Veerasaravanans/dog-bot/project report/generated_images/fig_5_11_block_diagram.png

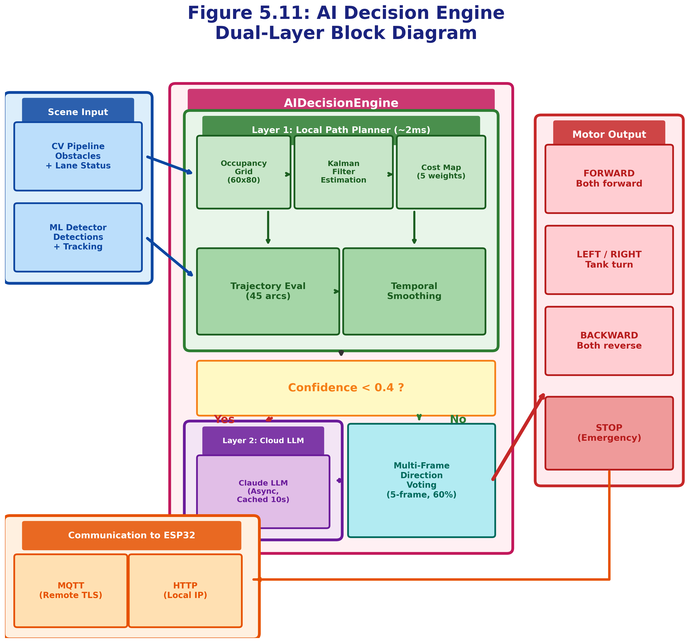
project report/generated_images/fig_5_11_block_diagram.png
