Veerasaravanans/dog-bot/project report/generated_images/fig_3_3_block_diagram.png

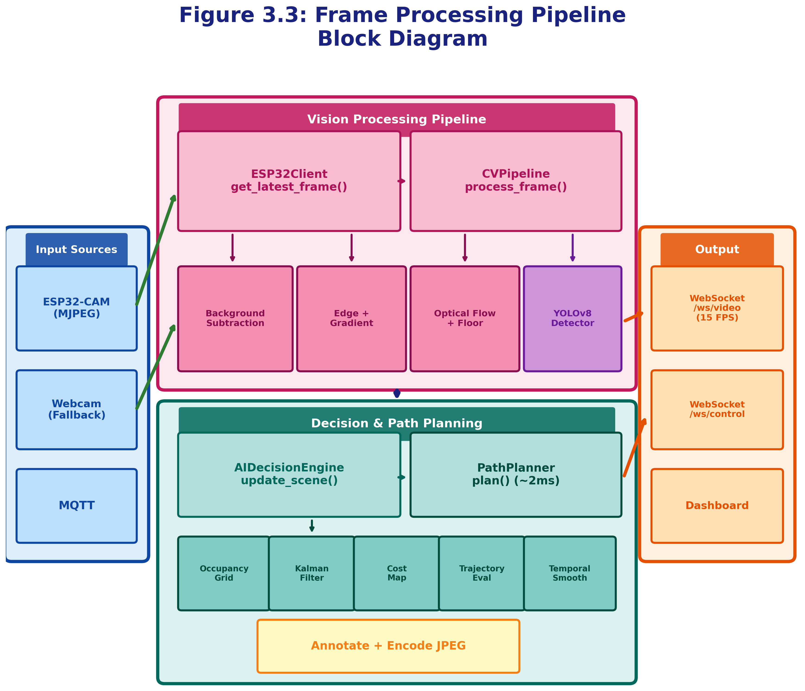
project report/generated_images/fig_3_3_block_diagram.png
