Veerasaravanans/dog-bot/pattent and paper presentation/6_ABSTRACT.docx

“Gesture-Controlled Autonomous Navigation System using Robot Operating System 2”

ABSTRACT

This paper primarily outlines a gesture-controlled autonomous navigation system for a four-wheeled robot based on ROS2 and different sensor technologies. The system employs a capacitive touch sensor, a magnetometer, and an ultrasonic sensor to facilitate easy robot control in the Gazebo simulation environment. The capacitive touch sensor identifies hand gestures, the magnetometer decides directional input, and the ultrasonic sensor helps in detecting obstacles. Hardware equipment consists of a microcontroller used to process sensory information and transfer it to ROS2 through Bluetooth. This set of equipment prevents jerky robotic movement changes as well as fine control over movement. Integration between ROS2 and Gazebo enables real-time simulation and testability, saves on development expenditures, and ensures improved robotic-human interaction. The system has possible uses in assistive robotics, automation, and robotic control without hands, and it represents a valuable development in autonomous navigation.
