Veerasaravanans/dog-bot/project report/Student’s Project Book Report.docx

# PROJECT BOOK

BATCH 2022-2026

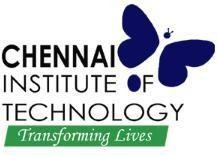
[picture p3: figure]

CHENNAI INSTITUTE OF TECHNOLOGY

CHENNAI-600069

ACADEMIC YEAR 2025-2026

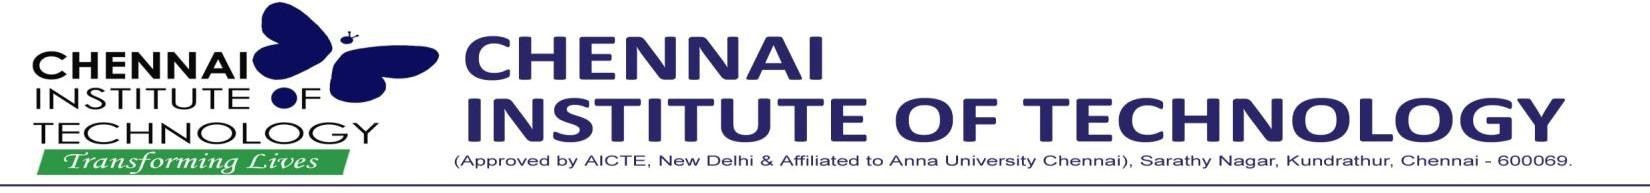
[picture p4: figure]

Vision of the Institute

To be an eminent centre for Academia, Industry and Research by imparting knowledge, relevant practices and inculcating human values to address global challenges through novelty and sustainability.

Mission of the Institute

IM1:To creates next generation leaders by effective teaching learning methodologies and instill scientific spark in them to meet the global challenges.

IM2:To transform lives through deployment of emerging technology, novelty and sustainability.

IM3:To inculcate human values and ethical principles to cater the societal needs.

IM4:To contributes towards the research ecosystem by providing a suitable, effective platform for interaction between industry, academia and R & D establishments.

IM5:To nurture incubation centers enabling structured entrepreneurship and start-ups.

Vision of the Department:

To Excel in the emerging areas of Mechatronics Engineering by imparting knowledge, relevant practices and inculcating human values to transform the students as potential resources to cater the needs of the industries and society in order to uphold the sustained automation process.

Mission of the Department:

DM1: To provide strong fundamentals and technical skills in Mechatronics Engineering through effective teaching-learning Methodologies.

- DM2: To transform the lives of the students by fostering ethical values, creativity, and innovation to become Entrepreneurs and establish Start-ups.
- DM3: To habituate the students to focus on sustainable solutions to improve the quality of life and welfare of the society.
- DM4: To provide an ambiance for research through collaborations with industry and academia.
- DM5: To inculcate learning of emerging technologies for pursuing higher studies leading to lifelong learning.

Program Educational Objectives (PEOs)

Graduates will be able to

PEO1. Contribute to the industry as an Engineer through sound knowledge acquired in core engineering to develop new processes and implement the solutions for industrial problems.

PEO2. Establish an organization / industry as an Entrepreneur with professionalism, leadership quality, teamwork, and ethical values to meet the societal needs.

PEO3. Create a better future by pursuing higher education / research and develop the sustainable products / solutions to meet the demand.

Program Specific Outcomes (PSOs)

S.No | Programme Specific Outcomes
PSO1 | Application of Engineering knowledge – To analyze, design and develop solutions by applying the concepts of Robotics for societal and industrial needs.
PSO2 | To create innovative ideas and solutions for real time problems in Manufacturing sector by adapting the emerging technologies and modern tools.

Program Outcomes with Graduate Attribute

S.No | Graduate Attribute | Program Outcomes
1. | Engineering knowledge | Apply knowledge of mathematics, natural science, computing, engineering fundamentals and an engineering specialization to develop to the solution of complex engineering problems.
2. | Problem analysis | Identify, formulate, review research literature and analyze complex engineering problems reaching substantiated conclusions with consideration for sustainable development.
3. | Design/Development of solutions | Design creative solutions for complex engineering problems and design/develop systems/components/processes to meet identified needs with consideration for the public health and safety, whole-life cost, net zero carbon, culture, society and environment as required.
4. | Conduct investigations of complex problems | Conduct investigations of complex engineering problems using research-based knowledge including design of experiments, modelling, analysis & interpretation of data to provide valid conclusions.
5. | Modern Tool usage | Create, select and apply appropriate techniques, resources and modern engineering & IT tools, including prediction and modelling recognizing their limitations to solve complex engineering problems.
6. | The Engineer and society | Analyze and evaluate societal and environmental aspects while solving complex engineering problems for its impact on sustainability with reference to economy, health, safety, legal framework, culture and environment.
7. | Ethics | Apply ethical principles and commit to professional ethics, human values, diversity and inclusion; adhere to national & international laws.
8. | Individual and team work | Function effectively as an individual, and as a member or leader in diverse/multi-disciplinary teams.
9. | Communication | Communicate effectively and inclusively within the engineering community and society at large, such as being able to comprehend and write effective reports and design documentation, make effective presentations considering cultural, language, and learning differences.
10. | Project management and finance | Apply knowledge and understanding of engineering management principles and economic decision-making and apply these to one’s own work, as a member and leader in a team, and to manage projects and in multidisciplinary environments.
11. | Life-long learning | Recognize the need for, and have the preparation and ability for i) independent and life-long learning ii) adaptability to new and emerging technologies and iii) critical thinking in the broadest context of technological change.

## PERSONAL DATA

Name of the student
Univ.Reg.No: | | Degree | | Branch

Project Title

Name of the company in which the student has been permitted to the project

Address of the registered office of the company

Address of the location, where the project is actually done, if different from above
Name of the Guide
Designation
Department
Qualification
Experience
Contact Phone
Fax
Email
Review | 0 | 1 | 2 | 3 | 4(Final)
Dates
Date of commencement | | Expected date of completion | | Actual date of completion
Date of Submission of Draft Report/Demo | | Date of Approval of Draft Report/Demo | | Date of Approval of Final Report/Demo
Signature of the Student | Internal Guide | | External Guide | | | HOD

PROJECT PLANER

Sl | Description | Time Requirement (in days) | Cumulative Time
1. | Identification of work & Composing the Title | 3 | 3
2. | Preparation of Synopsys | 2 | 5
3. | Literature Survey | 5 | 10
4. | Definition of methodology & collecting the relevant data and material. | 4 | 14
5. | Design of experimental set-up | 7 | 21
6. | Fabrication of experimental set-up and data acquisition system. | 12 | 33
7. | Conducting the experiments & consolidating the results & observations. | 10 | 43
8. | Preparation of model and analysis | 8 | 51
9. | Result analysis, Comparison of results & preparation of conclusion | 7 | 58
10. | Preparation of Thesis. | 7 | 65
| Total | 65

ACTIVITY SCHEDULE FOR REVIEW PRESENTATION

Sl | Review Meeting | Activity / work completion | Remarks
1. | 1st Review | Title of the Project One page write-up (Synopsys) Company name and address in case of external project Company willingness – Certificate Name and contact details of Internal & External guides | 3 to 5 slide ppt
2. | 2nd Review | Literature collection Definition of methodology | 25 – 30% work Completion
3. | 3rd Review | Design of experimental set-up. Fabrication of experimental set-up and data acquisition system. Results & observations. Preparation of model and analysis. Comparison of results & presenting the conclusion with suitable graphs. | 80% Completion
4. | Final Review | Draft copy of the project report. Full presentation & getting approval for final project report printing. A draft copy of the paper based on the project outcome, for publication along with the guide. | 95% Completion

- The presentation should be done by using PPT.

## INSTRUCTIONS TO STUDENT

1. Project work is the most important part of the curriculum, carrying the maximum weight age of marks. Hence, it should be approached with due respect, hard work and sincerity.
2. Before using the Record notebook, the details on page 1 must be filled.
3. The project review is scheduled on specific dates of each month for specific groups of students. There will be four reviews. In review zero, the topic for the project will be finalized. The student must have obtained the letter of acceptance from the company by then. Once accepted by the Review Committee the Topic shall be confirmed.
4. Paste the copy of project review schedule
5. The dates of project reviews shall not be changed.
6. The confirmation letter from the company allowing the student to do the project work must be pasted in original,(after taking a photo copy for further reference /use) before appearing for the 1st review for finalizing the topic.
7. The student must take permission /leave of absence from the external guide and make adequate arrangements for to and fro travel to the college on the prescribed project review dates.
8. The student, in his own interest, must be present himself at the college at least one day before the review advance so that he may have the advantage of meeting the faculty for discussion/clarification/assistance in presentation etc.
9. The project department will commence the review at 8.00 am sharp. Late coming shall not be permitted and such student’s work will not be reviewed on the day. No student shall be admitted to Project Review without the Project Record Note book.
10. Students shall remain in the review Hall till the completion of all reviews scheduled for that day. This is to help the entire group to know/learn about other projects and their approach/progress etc.
11. Students can ask questions on the projects of others with the permission of the external expert during discussion time after each presentation.
12. Before appearing for a review, the student should obtain the comments of the external guide from the company on the progress/work/attendance of the investigator (student) duly signed and stamped.
13. Before presenting for attendance on the review date, the student must get the comments of the internal guide recorded below that of the external in proof of having noted the comments of the external. The internal guide must record his views and corrections required.
14. The review will be done by an external project advisor and a representative of the department assigned to a group of projects depending upon the subject.
15. After going through the record note and presentation, the member will record their views and provide the corrective measures, where required.
16. After each review and before leaving, the student shall get the signatures of the external expert and the project guide.
17. After each review and before the next review, the student shall get the signature of his parent/guardian on the comments of the various review authorities on the work done till the previous review.
18. All observations, discussions etc., must be recorded in the project note book in chronological by him, in the space provided.
19. A dairy shall be maintained by the student on daily basis to record the summery of work done by him, in the space is provided.
20. Student shall prepare thoroughly on all aspects of the project (including theoretical input and practical application required) before presenting himself for the review by the panel.
21. The student must keep in mind that the project review is an opportunity for him to display.
  - His knowledge of the subject,
  - Ability to identify the problem
  - Ability to choose an appropriate tool to solve it with skill
  - Ability to logically arrange his presentation; and
  - Communication skills
22. The review will include
  - Presentation by the student
  - Question and answer session
  - Video and audio recording of the session
  - Comments oral/written of the external/internal reviewers
23. The mark for each review (I-20, II-20, III-80 and IV-80) shall be recorded by the panel member both in the review record and in the Project Record note book. Any student absent for any reason shall not only be marked absent for the review, But also get ZERO as internal mark provided for that particular review. Internal mark is for individual not necessarily common for the batch, where more than one student involved. No leave of absence shall we granted for project review.
24. Student should write a synopsis of work done until then in pages provided for each review, before attending the review.

The DogBot Recon System is an autonomous reconnaissance robot designed for intelligent navigation and obstacle detection in complex environments. The system integrates advanced computer vision techniques with AI-powered decision-making to enable autonomous navigation capabilities. The robot utilizes an ESP32-CAM microcontroller for real-time visual perception, coupled with YOLOv8 object detection and segmentation models for environmental awareness. The core navigation system employs a multi-stage path planning algorithm incorporating occupancy grid mapping, Kalman filtering for obstacle state estimation, cost map generation, and trajectory evaluation. The system operates in multiple control modes (Manual, Semi-Autonomous) with seamless fallback mechanisms and supports both local network (HTTP) and remote (MQTT) connectivity options. A FastAPI-based backend orchestrates real-time frame processing at 15 FPS with WebSocket streaming for live video and control feedback. Computer vision algorithms provide multi-sensor fusion including background subtraction, edge detection, optical flow analysis, and perspective-based distance estimation. The AI decision engine implements a 5-frame voting mechanism to ensure robust directional decisions with confidence scoring and LLM fallback for low-confidence scenarios. Emergency stop protocols and adaptive recovery behaviors ensure safe autonomous operation in dynamic environments.

25. Student shall prepare an activity plan & Gantt chart before the first review & get it approved by the external and internal guides.
26. A suitable reward will be given for the best performer/project work.

# SPACE FOR PASTING

LETTER FROM COMPANY ACCEPTING THE STUDENT TO DO THE PROJECT

(In company’s letter head)

(Student must take photo copy of the letter for reference and use).

# SYNOPSIS / ABSTRACT

Topic Finalization on

The DogBot Recon System is an autonomous reconnaissance robot that uses an ESP32-CAM microcontroller for real-time vision and a YOLOv8n-seg model for object detection. It features a five-stage path planning pipeline with occupancy grid mapping, Kalman filtering, cost map generation, trajectory evaluation, and temporal smoothing. A FastAPI backend processes frames at 15 FPS with WebSocket streaming. The AI decision engine uses five-frame voting with LLM fallback for robust navigation. The system supports local HTTP and remote MQTT connectivity with emergency stop and recovery behaviors for safe autonomous operation.

Internal Guide Project Advisor/Project coordinator Head of the Department

## PROJECT ACTIVITY PLANNER

Sl.No | Activity | Planned | | | Actual | | | Remarks
| | Start date | Finish date | Duration | Start date | Finish date | Duration | 1.Reason for deviation of any corrective | 2.Internal Guide Signature | 3.External Guide Signature
1 | Problem identification & literature survey | 01-Jan-2026 | 05-Jan-2026 | 5 days | 01-Jan-2026 | 05-Jan-2026 | 5 days | Surveyed 15+ papers on autonomous robots
2 | Project title finalization & synopsis writing | 06-Jan-2026 | 08-Jan-2026 | 3 days | 06-Jan-2026 | 08-Jan-2026 | 3 days | Title: DogBot Recon System
3 | Hardware procurement (ESP32-CAM, L298N, motors, chassis) | 09-Jan-2026 | 15-Jan-2026 | 7 days | 09-Jan-2026 | 14-Jan-2026 | 6 days | All components received
4 | ESP32-CAM firmware development (camera + WiFi + motor control) | 16-Jan-2026 | 25-Jan-2026 | 10 days | 15-Jan-2026 | 26-Jan-2026 | 12 days | MJPEG stream + HTTP motor API
5 | Hardware assembly & wiring (ESP32 + L298N + motors) | 20-Jan-2026 | 24-Jan-2026 | 5 days | 20-Jan-2026 | 24-Jan-2026 | 5 days | Tank-drive chassis built
6 | FastAPI backend setup & ESP32 client integration | 26-Jan-2026 | 30-Jan-2026 | 5 days | 27-Jan-2026 | 31-Jan-2026 | 5 days | WebSocket + REST API ready
7 | Computer vision pipeline (MOG2, Canny, Sobel, optical flow) | 31-Jan-2026 | 08-Feb-2026 | 9 days | 01-Feb-2026 | 09-Feb-2026 | 9 days | Multi-sensor fusion working
8 | YOLOv8 object detection & ByteTrack integration | 05-Feb-2026 | 10-Feb-2026 | 6 days | 05-Feb-2026 | 10-Feb-2026 | 6 days | YOLOv8n-seg with tracking
9 | Path planning engine (5-stage pipeline: occupancy grid, Kalman, cost map, DWA, EMA) | 10-Feb-2026 | 18-Feb-2026 | 9 days | 10-Feb-2026 | 19-Feb-2026 | 10 days | ~2ms per frame latency
10 | AI decision engine (multi-frame voting, pulse control) | 16-Feb-2026 | 20-Feb-2026 | 5 days | 17-Feb-2026 | 21-Feb-2026 | 5 days | 60% majority voting system
11 | MQTT remote connectivity (HiveMQ Cloud, TLS) | 18-Feb-2026 | 22-Feb-2026 | 5 days | 19-Feb-2026 | 23-Feb-2026 | 5 days | Remote control via internet
12 | VIO Cloud LLM integration (Claude API fallback) | 21-Feb-2026 | 24-Feb-2026 | 4 days | 22-Feb-2026 | 25-Feb-2026 | 4 days | Non-blocking background queries
13 | Web dashboard (real-time video, controls, telemetry) | 22-Feb-2026 | 27-Feb-2026 | 6 days | 23-Feb-2026 | 27-Feb-2026 | 5 days | Tactical UI with live feed
14 | System integration testing & performance tuning | 27-Feb-2026 | 03-Mar-2026 | 5 days | 28-Feb-2026 | 04-Mar-2026 | 5 days | 15 FPS achieved, all modes tested
15 | Documentation, project report & final demo preparation | 03-Mar-2026 | 06-Mar-2026 | 4 days | 04-Mar-2026 | 06-Mar-2026 | 3 days | Report and KT document ready

Student’s Project Record book 2025-2026

REPORTING SHEET

Student's Name

Branch Register No.

Project Title

Company

Record of attendance from to

Date | Place | Purpose | Time | | Sign
| | | In | Out

DIARY OF DAILY ACTIVITIES

Diary of daily activities from to .

S.No | Date | Brief note of activities | Remarks
1 | 01-Jan-2026 | Surveyed existing autonomous robot projects; studied ROS-based and ESP32-based designs; identified project scope and objectives. | Literature review
2 | 02-Jan-2026 | Reviewed research papers on obstacle avoidance using computer vision; studied YOLOv8 architecture and real-time detection approaches. | Paper study
3 | 03-Jan-2026 | Studied MQTT protocol for IoT communication; analysed HiveMQ Cloud broker features; compared with HTTP polling approach. | Protocol analysis
4 | 04-Jan-2026 | Studied Kalman filtering theory for object tracking; reviewed occupancy grid mapping techniques used in mobile robotics. | Algorithm study
5 | 05-Jan-2026 | Completed literature survey; prepared comparison table of existing systems; identified research gaps to address. | Survey completed
6 | 06-Jan-2026 | Finalized project title: 'DogBot Recon System – Autonomous Reconnaissance Robot with AI-Powered Navigation'; drafted one-page synopsis. | Title finalized
7 | 07-Jan-2026 | Prepared block diagram and system architecture showing three-layer design (embedded, backend, frontend); reviewed with guide. | Architecture design
8 | 08-Jan-2026 | Wrote detailed synopsis covering objectives, methodology, expected outcomes; submitted for Review 0 approval. | Synopsis submitted
9 | 09-Jan-2026 | Ordered ESP32-CAM (AI-Thinker), L298N motor driver, DC gear motors, robot chassis kit, jumper wires, and breadboard. | Hardware ordered
10 | 10-Jan-2026 | Studied ESP32-CAM datasheet and pin configuration; explored OV2640 camera module specifications and MJPEG streaming. | Datasheet study
11 | 13-Jan-2026 | Received all hardware components; verified each component against specifications; organized workspace. | Components received
12 | 14-Jan-2026 | Set up Arduino IDE with ESP32 board support; installed required libraries (WiFi, WebServer, PubSubClient, esp_camera). | IDE setup
13 | 16-Jan-2026 | Developed basic ESP32-CAM firmware: initialized camera with VGA resolution, configured WiFi STA mode, tested serial output. | Camera init code
14 | 17-Jan-2026 | Implemented MJPEG streaming server on port 81 using FreeRTOS task pinned to Core 0; verified stream in browser. | Stream working
15 | 19-Jan-2026 | Developed HTTP control server on port 80; implemented /motor and /status API endpoints; tested motor direction control. | HTTP API ready
16 | 20-Jan-2026 | Assembled robot chassis; mounted ESP32-CAM on front; connected L298N motor driver with dual DC motors for tank steering. | Chassis assembled

DIARY OF DAILY ACTIVITIES

Diary of daily activities from to .

S.No | Date | Brief note of activities | Remarks
17 | 21-Jan-2026 | Wired L298N to ESP32-CAM GPIO pins (IN1:12, IN2:13, IN3:14, IN4:15, ENA:2, ENB:4); tested forward/back/left/right movements. | Wiring complete
18 | 22-Jan-2026 | Implemented PWM speed control using ESP32 LEDC peripheral (1 kHz, 8-bit); added motor trim compensation for drift correction. | PWM control added
19 | 23-Jan-2026 | Integrated MQTT client with TLS on ESP32; configured HiveMQ Cloud broker; tested publish/subscribe for motor commands. | MQTT on ESP32
20 | 24-Jan-2026 | Added auto-stop safety failsafe (800ms timeout); tested remote motor control via MQTT; verified heartbeat/status publishing. | Safety failsafe added
21 | 26-Jan-2026 | Set up Python backend environment; installed FastAPI, uvicorn, OpenCV, NumPy, httpx, aiomqtt, ultralytics, Pydantic. | Backend env setup
22 | 27-Jan-2026 | Developed ESP32Client service: MJPEG stream parser (FFD8/FFD9 markers), async frame capture, webcam fallback mechanism. | ESP32 client coded
23 | 28-Jan-2026 | Created FastAPI application structure with lifespan manager; designed service orchestration pattern with dependency-ordered startup. | FastAPI app structure
24 | 29-Jan-2026 | Implemented WebSocket endpoints for video streaming (/ws/video) and bidirectional control (/ws/control) with pub/sub pattern. | WebSocket endpoints
25 | 30-Jan-2026 | Designed Pydantic data models: Detection, TrackedObstacle, LaneStatus, AIDecision, FrameResult, SystemTelemetry schemas. | Data models designed
26 | 31-Jan-2026 | Solved Windows asyncio event loop issue; created run.py with SelectorEventLoop for MQTT compatibility on Windows. | Windows fix
27 | 01-Feb-2026 | Started CV pipeline: implemented background subtraction using MOG2 (history=300, varThreshold=40) for foreground detection. | MOG2 implemented
28 | 02-Feb-2026 | Added Canny edge detection (low=50, high=150) with Gaussian blur pre-processing; implemented contour-based obstacle extraction. | Edge detection
29 | 03-Feb-2026 | Implemented Sobel gradient magnitude computation for texture-agnostic detection; added thin-edge map for poles and desk legs. | Gradient detection
30 | 04-Feb-2026 | Developed perspective-based distance estimation using inverse perspective mapping (DIST_SCALE=80, VANISH_Y_FRAC=0.30). | Distance estimation
31 | 05-Feb-2026 | Implemented lane classification (LEFT/CENTER/RIGHT) and free-path analysis; developed centroid-based multi-object tracker. | Lane + tracking
32 | 06-Feb-2026 | Added dense optical flow (Farneback) for moving obstacle detection; implemented vanishing point auto-detection via Hough transform. | Optical flow added

DIARY OF DAILY ACTIVITIES

Diary of daily activities from to .

S.No | Date | Brief note of activities | Remarks
33 | 07-Feb-2026 | Developed adaptive floor colour model using HSV Exponential Moving Average (alpha=0.05) to detect non-floor anomalies. | Floor model
34 | 08-Feb-2026 | Implemented reverse-camera style visualization with trapezoidal distance grid, zone colouring (DANGER/CAUTION/SAFE), and overlays. | Visualization done
35 | 09-Feb-2026 | Integrated YOLOv8n-seg model; configured inference with ByteTrack for persistent multi-object tracking across frames. | YOLOv8 integrated
36 | 10-Feb-2026 | Developed ML detection drawing with semi-transparent segmentation mask overlays; tested instance segmentation on live feed. | Segmentation overlay
37 | 11-Feb-2026 | Started path planner: built occupancy grid (60×80 cells, 5cm resolution); implemented pixel-to-world projection with temporal decay. | Occupancy grid
38 | 12-Feb-2026 | Implemented per-obstacle Kalman filter (4-state: x, y, vx, vy); developed predict/update cycle with stale track removal. | Kalman filter coded
39 | 14-Feb-2026 | Developed cost map generator with 5 weighted components: occupancy, repulsive field, predictive cost, boundary, and attractive field. | Cost map generator
40 | 16-Feb-2026 | Implemented Dynamic Window Approach trajectory evaluator: 45 candidate arcs (15 steering × 3 speeds) with 5-cost scoring function. | DWA evaluator
41 | 17-Feb-2026 | Added temporal smoothing (EMA alpha=0.33), direction hold (300ms), and recovery behaviour for blocked scenarios. | Smoothing + recovery
42 | 18-Feb-2026 | Developed AI decision engine with multi-frame direction voting (5-frame window, 60% majority); implemented pulse-based motor control. | AI decision engine
43 | 19-Feb-2026 | Implemented MQTTBridge service: TLS connection to HiveMQ Cloud, async message handling, auto-reconnect, dual connectivity fallback. | MQTT bridge coded
44 | 22-Feb-2026 | Integrated VIO Cloud LLM (Claude API) as fallback advisor; implemented non-blocking background queries with 10-second caching. | LLM integration
45 | 23-Feb-2026 | Built web dashboard with live video feed, directional controls, speed slider, mode toggle, telemetry panel, and detection log. | Dashboard built
46 | 28-Feb-2026 | Conducted full system integration test: ESP32 streaming → CV + ML processing → path planning → AI decisions → motor control loop. | Integration test
47 | 04-Mar-2026 | Performance tuning: achieved 15 FPS processing, 2ms path planning latency; tuned cost weights and emergency stop distances. | Performance tuned
48 | 06-Mar-2026 | Prepared final documentation, project report content, knowledge transfer document, and demo presentation materials. | Documentation done

REVIEW SUMMARY

FIRST REVIEW on

Project scope, architecture, and hardware were finalized. ESP32-CAM was selected for vision, FastAPI for backend, L293D for motor control, and MQTT via HiveMQ Cloud for remote connectivity. The service orchestration pattern with FrameManager as coordinator was designed. System requirements and feasibility were reviewed and approved. The data flow pipeline from ESP32 capture through CV processing, ML detection, and path planning to WebSocket broadcast was mapped out. Pydantic-based configuration management and asyncio service lifecycle patterns were established. A literature survey on autonomous navigation techniques and embedded vision systems was completed to validate the chosen approach.

Internal Guide Project Advisor/Project coordinator Head of the Department

2025-2026 Project Review Evaluation / Comments

FIRST REVIEW on

Comments

Date: Signature
External Project Advisor's Name:
Company:
Comments
Date: Signature | Marks Out of 10

Project Officer/Advisor's Name:
Comments
Date: Signature | Out of 10

REVIEW SUMMARY

SECOND REVIEW on

Hardware and software integration was completed. ESP32-CAM firmware with dual-server design, CV pipeline with multi-sensor fusion (background subtraction, edge detection, optical flow), and the first three path planner stages (occupancy grid, Kalman filtering, cost map) were implemented. WebSocket streaming and webcam fallback were verified. System achieved 15 FPS target. Distance zones were calibrated at 0.5m near and 1.2m mid boundaries using perspective-based estimation. The FastAPI backend lifespan manager was verified to start and stop all services in correct dependency order. Centroid-based obstacle tracking with ID assignment and velocity estimation was implemented for persistent multi-frame obstacle monitoring.

Internal Guide Project Advisor/Project coordinator Head of the Department

2025-2026 Project Review Evaluation / Comments

SECOND REVIEW on

Comments

Date: Signature
External Project Advisor's Name:
Company:
Comments
Date: Signature | Marks Out of 10

Project Officer/Advisor's Name:
Comments
Date: Signature | Out of 10

*Cumulative marks secured in 1st

REVIEW SUMMARY THIRD REVIEW on

YOLOv8n-seg with ByteTrack tracking and the trajectory evaluator (41 candidate arcs) were integrated, completing the five-stage path planner. The AI decision engine with five-frame voting and VIO Cloud LLM fallback was deployed. MQTT remote connectivity was tested end-to-end. Full system integration demonstrated sub-2ms planning latency. The trajectory scoring uses weighted costs for obstacle proximity, heading deviation, smoothness, clearance, and forward progress. The web dashboard was completed with real-time telemetry display, control mode switching, and live video streaming. Dual connectivity architecture with MQTT as primary and HTTP as fallback was validated for seamless local and remote operation.

Internal Guide Project Advisor/Project coordinator Head of the Department

2025-2026 Project Review Evaluation / Comments

THIRD REVIEW on

Comments

Date: Signature
External Project Advisor's Name:
Company:
Comments
Date: Signature | Marks Out of 10

Project Officer/Advisor's Name:
Comments
Date: Signature | Out of 10

*Cumulative marks secured in 1st, & 2nd Reviews

REVIEW SUMMARY FORTH REVIEW on

Emergency stop at 0.25m, adaptive recovery turns, and motor drift compensation were implemented. Windows asyncio compatibility was fixed via run.py. Failsafe mechanisms (webcam fallback, MQTT reconnection, 500ms auto-stop) were validated. Web dashboard, documentation, and deployment procedures were completed. System achieved production-ready status. Floor plane detection was finalized with adaptive color modeling using exponential moving average for robust ground segmentation. The system was tested in real-world indoor environments demonstrating reliable autonomous navigation and obstacle avoidance. Pin diagram reference and setup guide pages were added to the dashboard for easy hardware assembly and configuration.

Internal Guide Project Advisor/Project coordinator Head of the Department

2025-2026 Project Review Evaluation / Comments

FOURTH REVIEW on

Comments

Date: Signature
External Project Advisor's Name:
Company:
Comments
Date: Signature | Marks Out of 10

Project Officer/Advisor's Name:
Comments
Date: Signature | Out of 10

*Cumulative marks secured in 1st, 2nd and 3rd Reviews

SYNOPSIS / ABSTRACT FINAL DRAFT

The DogBot Recon System is an ESP32-CAM based autonomous robot using YOLOv8n-seg for detection and a five-stage path planner for navigation. A FastAPI backend with WebSocket streaming processes vision at 15 FPS. The AI engine uses five-frame voting with LLM fallback. It supports HTTP and MQTT connectivity, emergency stop protocols, and adaptive recovery for safe indoor reconnaissance.

Internal Guide Project Advisor/Project coordinator Head of the Department

# TECHNICAL PAPERS PUBLISHED

S. No | Title | Journal | Impact Factor | Issue Date | Published Date
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
*Attach the copy of the papers published.

# CONFERENCES ATTENDED

S. No | Conference Date | Title of Conference | Paper Published | Organized By | Remarks
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
*Attach the copy of the papers published.

TECHNICAL PAPERS & BOOKS REFERRED

Sl.No | Title | Author | Page No.
1 | YOLOv8: A Novel Object Detection Algorithm with Enhanced Performance and Efficiency | G. Jocher, A. Chaurasia, J. Qiu (Ultralytics) | 2023
2 | ByteTrack: Multi-Object Tracking by Associating Every Detection Box | Y. Zhang, P. Sun, Y. Jiang et al. | ECCV 2022, pp. 1-21
3 | An Introduction to the Kalman Filter | G. Welch, G. Bishop | UNC Chapel Hill, TR 95-041
4 | The Dynamic Window Approach to Collision Avoidance | D. Fox, W. Burgard, S. Thrun | IEEE Robotics & Automation, 1997, pp. 23-33
5 | OpenCV: Open Source Computer Vision Library | G. Bradski | Dr. Dobb's Journal, 2000
6 | Background Subtraction Techniques: A Review (MOG2 / Gaussian Mixture Models) | Z. Zivkovic | Pattern Recognition Letters, Vol. 27, 2006, pp. 773-780
7 | Two-Frame Motion Estimation Based on Polynomial Expansion (Farneback Optical Flow) | G. Farneback | SCIA 2003, LNCS 2749, pp. 363-370
8 | FastAPI: Modern, High-Performance Web Framework for Building APIs with Python | S. Ramirez | https://fastapi.tiangolo.com, 2019
9 | MQTT Version 3.1.1 – OASIS Standard | A. Banks, R. Gupta (Eds.) | OASIS, 2014
10 | ESP32 Technical Reference Manual | Espressif Systems | V5.1, 2024
11 | Probabilistic Robotics | S. Thrun, W. Burgard, D. Fox | MIT Press, 2005, Ch. 3-5, 9
12 | Artificial Potential Fields for Mobile Robot Navigation | O. Khatib | Int. J. Robotics Research, Vol. 5, 1986, pp. 90-98
13 | A Computational Approach to Edge Detection (Canny Edge Detector) | J. Canny | IEEE Trans. PAMI, Vol. 8, 1986, pp. 679-698
14 | Python Asyncio: Asynchronous I/O, Event Loop, and Concurrency Tools | Python Software Foundation | Python 3.12 Documentation, 2024
15 | Pydantic: Data Validation Using Python Type Annotations | S. Colvin | https://docs.pydantic.dev, V2, 2023
16 | Real-Time Object Detection and Tracking for Autonomous Mobile Robots: A Survey | M. Liu, S. Chen, F. Wu | Sensors, Vol. 23, 2023, pp. 1-28
17 | Computer Vision: Algorithms and Applications | R. Szeliski | Springer, 2nd Ed., 2022, Ch. 4-8
18 | Occupancy Grid Mapping for Mobile Robot Navigation | A. Elfes | IEEE Computer, Vol. 22, 1989, pp. 46-57
19 | Deep Learning for Object Detection: A Comprehensive Review (YOLO family) | Z. Zou, K. Chen, Z. Shi et al. | Proc. IEEE, Vol. 111, 2023, pp. 11-42
20 | WebSocket Protocol (RFC 6455) | I. Fette, A. Melnikov | IETF RFC 6455, 2011

## 1st Review Summary

The foundation of DogBot Recon System was established with a comprehensive project plan covering system architecture, hardware selection, and software framework design. Key decisions included ESP32-CAM as the primary vision platform, FastAPI for backend development, and MQTT for remote connectivity. Initial system requirements and design specifications were reviewed and approved. The project scope was defined to include autonomous navigation, obstacle detection, and real-time video processing at 15 FPS.

## 2nd Review Summary

The implementation phase demonstrated successful integration of hardware components including ESP32-CAM, L293D motor controller, and supporting sensors. The computer vision pipeline was implemented with background subtraction, edge detection, and optical flow analysis. The path planning engine's first three stages were completed: occupancy grid mapping, obstacle state estimation using Kalman filtering, and cost map generation. WebSocket streaming was verified for video and control channels. System successfully demonstrated real-time processing at target 15 FPS throughput.

## 3rd Review Summary

The advanced decision-making and path planning components were finalized and integrated. YOLOv8n-seg object detection and ByteTrack multi-object tracking were successfully implemented and optimized. The trajectory evaluator completing the 5-stage path planner pipeline was integrated with 41 candidate arc evaluation and confidence scoring. The AI decision engine with 5-frame voting mechanism was deployed. Remote connectivity via MQTT was tested with proper TLS configuration. Full end-to-end system integration testing demonstrated seamless coordination between all components.

## 4th Review Summary

The final phase focused on system optimization, robustness testing, and documentation. Emergency stop protocols and adaptive recovery behaviors were implemented and tested. Event loop policy fixes ensured Windows compatibility for production deployment. Failsafe mechanisms including automatic webcam fallback and graceful MQTT reconnection were validated. Comprehensive documentation including architecture overview, troubleshooting guides, and deployment procedures was completed. The system achieved production-ready status with demonstrated autonomous navigation capabilities in real-world test environments.

Student’s Project Record book 2025-2026

Internal Guide Project Advisor/Project coordinator Head of the Department
