Veerasaravanans/dog-bot/pattent and paper presentation/7_DRAWING.docx

“Gesture-Controlled Autonomous Navigation System using Robot Operating System 2”

DRAWINGS

Figure-I Block Diagram of the proposed system

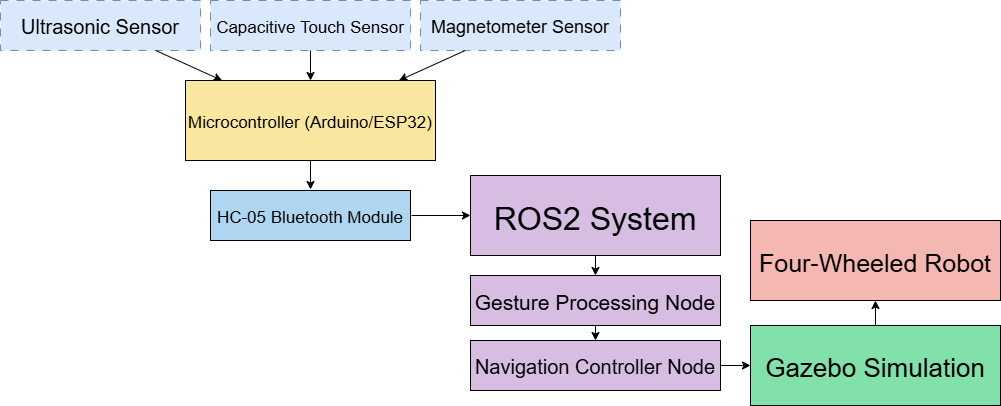
[picture p25: figure]

FIGURE 2: Working model of the proposed system

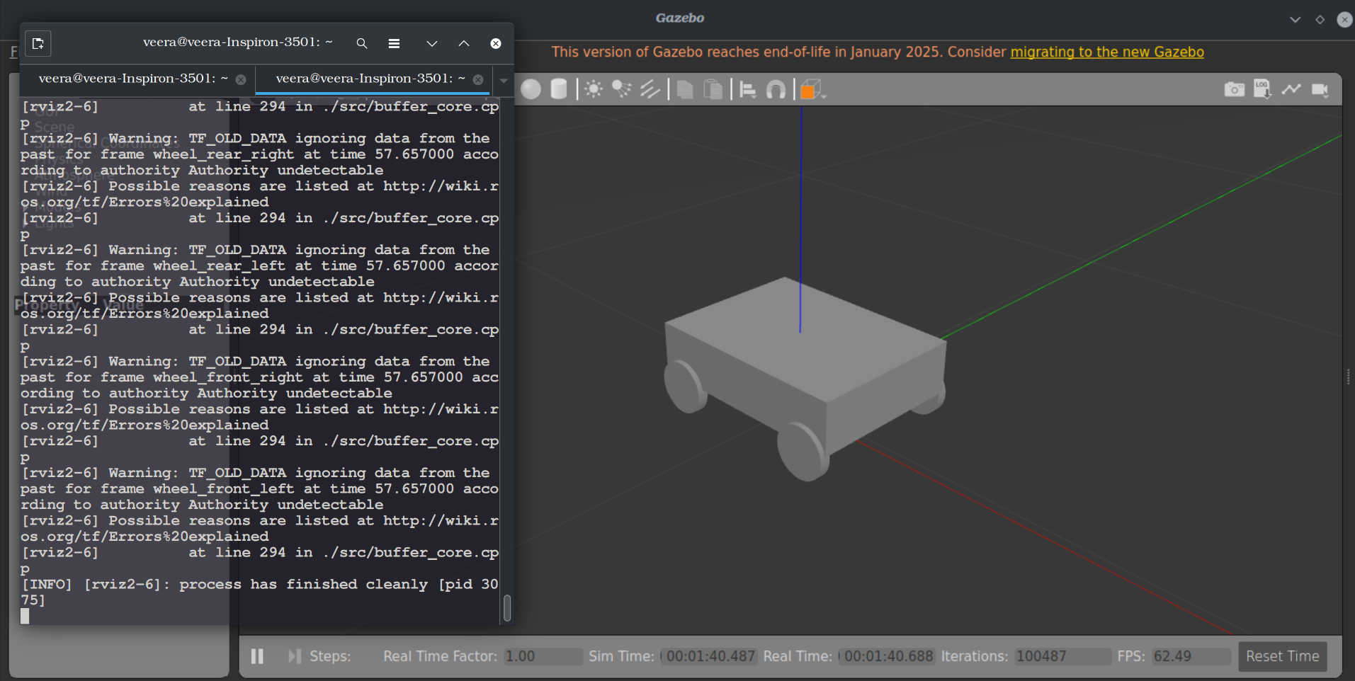
[picture p26: figure]
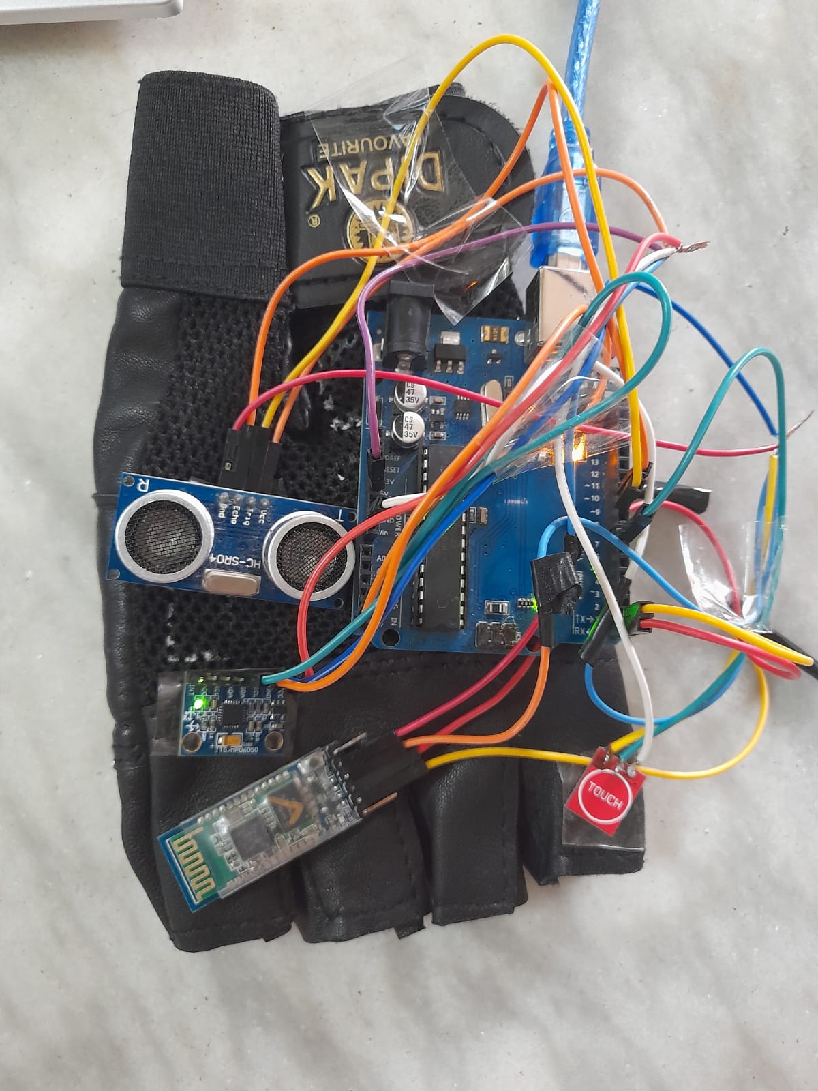
[picture p27: figure]
