Veerasaravanans/dog-bot/project report/block dia and graphs.docx

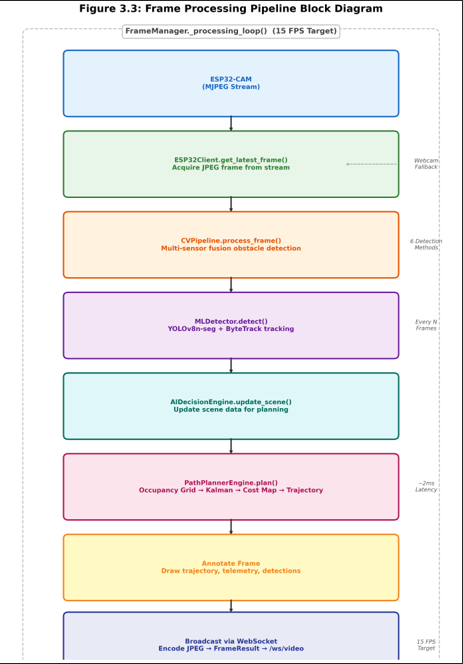
[picture p28: figure]

Fig 3.2.1

Fig 5.7.1

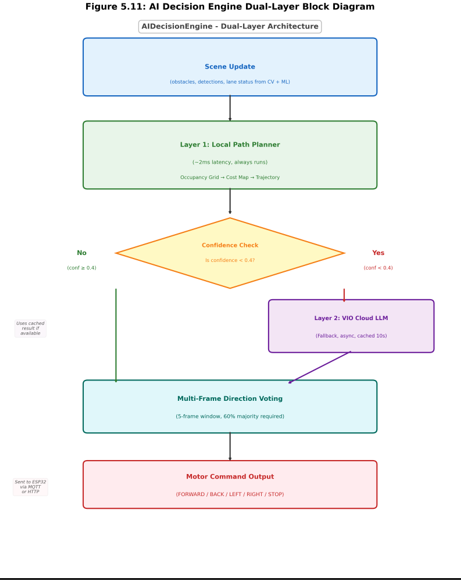
[picture p29: figure]

Table 4.7.2

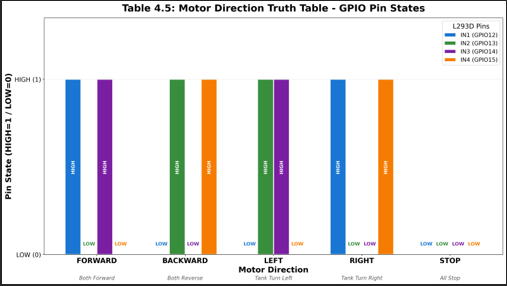
[picture p30: figure]

Table 6.2.1

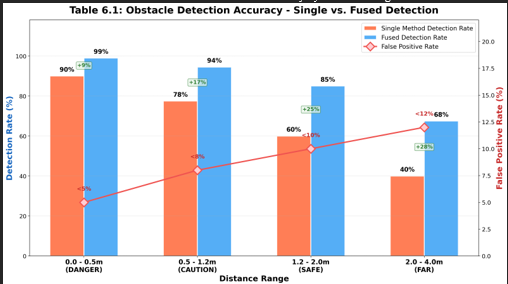
[picture p31: figure]
