Veerasaravanans/dog-bot/fix and md/REMOTE_ACCESS_GUIDE.md

# Remote ESP32-CAM Access Guide

## Current Situation

**Problem:** Your ESP32-CAM is on a local network (192.168.1.100) in Chennai, but you want to access it remotely from anywhere.

**Current Architecture:**
- ✅ **MQTT Control:** Already working! Motor commands work remotely via HiveMQ Cloud
- ❌ **Video Stream:** Only works on local network (HTTP MJPEG on port 81)
- ✅ **Motor Status:** Published to MQTT (accessible remotely)

---

## Solution Options (Ranked by Ease)

### **Option 1: VPN - RECOMMENDED** ⭐
**Best for:** Secure remote access without firmware changes

#### How It Works
1. Set up VPN server on the same network as your ESP32-CAM (in Chennai)
2. Connect to VPN from anywhere
3. Access ESP32-CAM as if you're on the local network

#### Steps:
```bash
# On router/server in Chennai:
# Install OpenVPN, WireGuard, or use Tailscale (easiest)

# Example with Tailscale (free, super easy):
1. Install Tailscale on a computer in Chennai network
2. Install Tailscale on your remote computer
3. Both join same Tailscale network
4. Access ESP32 at its local IP (192.168.1.100)
```

#### Pros:
- ✅ Secure (encrypted)
- ✅ No firmware changes needed
- ✅ Works for all devices on the network
- ✅ Video stream works at full quality

#### Cons:
- ⚠️ Requires VPN server/client setup
- ⚠️ Needs a computer/Pi running 24/7 in Chennai

---

### **Option 2: Port Forwarding** ⚠️
**Best for:** Quick testing (NOT recommended for production)

#### How It Works
1. Forward external port (e.g., 8081) to ESP32-CAM's port 81
2. Access via your public IP: `http://YOUR_PUBLIC_IP:8081/stream`

#### Steps:
```bash
# On router in Chennai:
1. Find ESP32 local IP: 192.168.1.100
2. Log into router admin panel
3. Port Forwarding settings:
   - External Port: 8081
   - Internal IP: 192.168.1.100
   - Internal Port: 81
   - Protocol: TCP
4. Find your public IP: curl ifconfig.me
5. Access: http://YOUR_PUBLIC_IP:8081/stream
```

#### Pros:
- ✅ Simple setup
- ✅ No firmware changes
- ✅ Direct access

#### Cons:
- ❌ **MAJOR SECURITY RISK** (anyone can access if they know your IP)
- ❌ No encryption
- ❌ Public IP might change (need DDNS)
- ❌ ISP might block incoming connections

---

### **Option 3: Cloud Relay Service** 🌐
**Best for:** Simplest for non-technical users

#### Recommended Services:
1. **ngrok** (free tier available)
   ```bash
   # Install ngrok on computer in Chennai
   ngrok http 192.168.1.100:81
   # Get public URL: https://abc123.ngrok.io
   ```

2. **Cloudflare Tunnel** (free)
   ```bash
   # Install cloudflared in Chennai
   cloudflared tunnel --url http://192.168.1.100:81
   ```

3. **Tailscale + Funnel** (free, easiest)
   ```bash
   # Expose local service publicly
   tailscale funnel 81
   ```

#### Pros:
- ✅ No router configuration needed
- ✅ HTTPS encryption included
- ✅ Easy to set up
- ✅ Firewall-friendly

#### Cons:
- ⚠️ Free tiers have bandwidth/time limits
- ⚠️ Third-party service dependency
- ⚠️ May have latency

---

### **Option 4: Update .env to Use MQTT Backend (Current Workaround)**
**Best for:** Testing with webcam fallback

Your system already handles this gracefully:
```bash
# Edit .env file:
ESP32_STREAM_URL=http://192.168.1.100:81/stream  # Can't reach from remote

# System automatically:
# 1. Tries ESP32 stream
# 2. Falls back to local webcam ✅
# 3. MQTT control still works ✅
```

#### Current Status:
- ✅ Motor control works remotely via MQTT
- ✅ Status updates work remotely via MQTT
- ✅ Local webcam provides video feed
- ❌ Can't see Chennai ESP32-CAM video

---

### **Option 5: Implement MQTT Video Streaming** 🔧
**Best for:** Advanced users, full remote capability

#### What Needs to Change:

**ESP32 Firmware Changes:**
```cpp
// Add MQTT video publishing to esp32cam_dogbot.ino
void mqttPublishFrame() {
  camera_fb_t * fb = esp_camera_fb_get();
  if (!fb) return;

  // Compress JPEG (already done by camera)
  // Split into chunks (MQTT message size limit ~256KB)
  size_t chunkSize = 4096;
  for (size_t i = 0; i < fb->len; i += chunkSize) {
    size_t len = min(chunkSize, fb->len - i);
    mqttClient.publish(TOPIC_FRAME, &fb->buf[i], len);
  }

  esp_camera_fb_return(fb);
}
```

**Backend Changes:**
```python
# backend/services/esp32_client.py
# Add MQTT frame subscriber
async def _on_mqtt_frame(self, message):
    # Reconstruct frame from MQTT chunks
    # Update self._frame
    pass
```

#### Pros:
- ✅ Fully remote without VPN/port forwarding
- ✅ Uses existing MQTT infrastructure
- ✅ Secure (TLS encryption)

#### Cons:
- ❌ Complex implementation
- ❌ MQTT bandwidth limitations
- ❌ Lower frame rate (3-5 FPS max realistic)
- ❌ Higher latency than HTTP streaming

---

## Recommended Solution for Your Setup

### **Immediate (Works Now):**
Use **Tailscale VPN** - Free, secure, easiest setup:

#### Quick Start:
```bash
# On a computer in Chennai (same network as ESP32):
1. Download Tailscale: https://tailscale.com/download
2. Install and sign in
3. Leave running 24/7

# On your remote computer:
1. Download Tailscale
2. Install and sign in (same account)
3. You're now on the same virtual network!

# Access ESP32:
http://192.168.1.100:81/stream  # Works as if you're local!
```

### **Alternative (Temporary Testing):**
Use **ngrok** for quick testing:

```bash
# On computer in Chennai:
1. Download ngrok: https://ngrok.com/download
2. Run: ngrok http 192.168.1.100:81
3. Copy the https://xyz.ngrok.io URL
4. Update .env:
   ESP32_STREAM_URL=https://xyz.ngrok.io/stream
5. Restart: python run.py
```

---

## Configuration Changes Needed

### **Update .env for Remote Access:**

```bash
# Current (local only):
ESP32_STREAM_URL=http://192.168.1.100:81/stream
ESP32_CONTROL_URL=http://192.168.1.100

# After VPN setup (Tailscale):
ESP32_STREAM_URL=http://192.168.1.100:81/stream  # Works through VPN
ESP32_CONTROL_URL=http://192.168.1.100

# After ngrok setup:
ESP32_STREAM_URL=https://abc123.ngrok.io/stream  # Public URL
ESP32_CONTROL_URL=https://abc123.ngrok.io

# For testing without ESP32:
# Leave as-is, system uses webcam fallback automatically
```

---

## Troubleshooting Remote Access

### **ESP32 Not Reachable:**
```bash
# Check if ESP32 is powered on
# Check WiFi connection (ESP32 Serial Monitor)
# Verify local network connectivity first

# From Chennai computer:
ping 192.168.1.100
curl http://192.168.1.100/status
```

### **MQTT Control Working but No Video:**
✅ **This is expected!** Your current setup:
- MQTT = Remote control ✅
- HTTP Stream = Local network only ❌

**Solution:** Set up VPN or ngrok (see above)

### **Firewall Issues:**
```bash
# ESP32 firmware includes CORS headers
# Should work from any origin

# If blocked, check:
- Windows Firewall
- Router firewall
- ISP restrictions
```

---

## Security Best Practices

### **DO:**
- ✅ Use VPN for remote access
- ✅ Use HTTPS/TLS when possible
- ✅ Keep firmware updated
- ✅ Use strong WiFi passwords

### **DON'T:**
- ❌ Expose ESP32 directly to internet without authentication
- ❌ Use port forwarding without firewall rules
- ❌ Share public URLs (ngrok links) publicly
- ❌ Hardcode passwords in firmware (use separate config file)

---

## Next Steps

1. **Choose a solution** (Recommended: Tailscale VPN)
2. **Set up remote access** following the guide above
3. **Update .env** with new ESP32_STREAM_URL
4. **Test connection** from remote location
5. **Update CLAUDE.md** with your remote access setup

---

## Quick Reference

| Method | Setup Time | Security | Cost | Recommended |
|---|---|---|---|---|
| Tailscale VPN | 5 min | ⭐⭐⭐⭐⭐ | Free | ✅ YES |
| ngrok | 2 min | ⭐⭐⭐⭐ | Free tier | ✅ For testing |
| Port Forwarding | 10 min | ⭐ | Free | ❌ Not secure |
| Cloudflare Tunnel | 15 min | ⭐⭐⭐⭐⭐ | Free | ✅ YES |
| MQTT Video | Days | ⭐⭐⭐⭐⭐ | Free | ❌ Complex |

---

## Support

For specific setup help:
- Tailscale: https://tailscale.com/kb/
- ngrok: https://ngrok.com/docs
- Cloudflare Tunnel: https://developers.cloudflare.com/cloudflare-one/connections/connect-apps/

For DogBot-specific issues, check `CLAUDE.md` troubleshooting section.
