Veerasaravanans/dog-bot/dashboard-print.html

🐕

DOG-BOT

TACTICAL RECONNAISSANCE UNIT

CAMERA

ONLINE

MOTOR CTRL

ONLINE

AI ENGINE

STANDBY

14:32:07 2026.02.15

0.5m

1.0m

2.0m

FPS 15.0

LATENCY 12ms

MODE MANUAL

OBSTACLES 0

EVIDENCE 0

N

REC 00:00:00

📏 0.0m

🕐 00:00:00

🎮 MANUAL 🤖 SEMI-AUTO

MOVEMENT CONTROL

▲

◀ STOP ▶

▼

SPEED 180

50 150 255

25%

CPU

60%

MEM

85%

BAT

LANE STATUS

LEFT

✓

CENTER

✓

RIGHT

✓

AI REASONING LOG

14:32:07 [ACT] System initialized. All services online.

14:32:08 [OBS] Camera feed connected. Resolution: 640x480

14:32:09 [ANA] Path clear. No obstacles detected in forward corridor.

14:32:10 [DEC] Navigation: FORWARD recommended. Confidence: 0.92

W

A

S

D

SPACE

SIGNAL

RSSI -65dBm

BATTERY

7.4V

CURRENT 0.8A

SPEED 0.0m/s

DIRECTION STOP

OBSTACLES 0

EVIDENCE 0

UPTIME 00:00:00

📷 SNAPSHOT 💾 SAVE LOG 🛑 E-STOP
