Veerasaravanans/dog-bot/firmware/test_camera_only.ino

/*
 * ESP32-CAM Camera Test Only
 * Use this to test if camera hardware is working
 */

#include "esp_camera.h"

// AI-Thinker ESP32-CAM Pins
#define PWDN_GPIO_NUM     32
#define RESET_GPIO_NUM    -1
#define XCLK_GPIO_NUM      0
#define SIOD_GPIO_NUM     26
#define SIOC_GPIO_NUM     27
#define Y9_GPIO_NUM       35
#define Y8_GPIO_NUM       34
#define Y7_GPIO_NUM       39
#define Y6_GPIO_NUM       36
#define Y5_GPIO_NUM       21
#define Y4_GPIO_NUM       19
#define Y3_GPIO_NUM       18
#define Y2_GPIO_NUM        5
#define VSYNC_GPIO_NUM    25
#define HREF_GPIO_NUM     23
#define PCLK_GPIO_NUM     22

void setup() {
  Serial.begin(115200);
  Serial.println("\n=== ESP32-CAM Test ===");

  // Check PSRAM
  if (psramFound()) {
    Serial.println("PSRAM: Found");
  } else {
    Serial.println("WARNING: PSRAM Not Found!");
  }

  // Configure camera
  camera_config_t config;
  config.ledc_channel = LEDC_CHANNEL_2;
  config.ledc_timer = LEDC_TIMER_1;
  config.pin_d0 = Y2_GPIO_NUM;
  config.pin_d1 = Y3_GPIO_NUM;
  config.pin_d2 = Y4_GPIO_NUM;
  config.pin_d3 = Y5_GPIO_NUM;
  config.pin_d4 = Y6_GPIO_NUM;
  config.pin_d5 = Y7_GPIO_NUM;
  config.pin_d6 = Y8_GPIO_NUM;
  config.pin_d7 = Y9_GPIO_NUM;
  config.pin_xclk = XCLK_GPIO_NUM;
  config.pin_pclk = PCLK_GPIO_NUM;
  config.pin_vsync = VSYNC_GPIO_NUM;
  config.pin_href = HREF_GPIO_NUM;
  config.pin_sccb_sda = SIOD_GPIO_NUM;
  config.pin_sccb_scl = SIOC_GPIO_NUM;
  config.pin_pwdn = PWDN_GPIO_NUM;
  config.pin_reset = RESET_GPIO_NUM;
  config.xclk_freq_hz = 20000000;
  config.pixel_format = PIXFORMAT_JPEG;
  config.frame_size = FRAMESIZE_QVGA;  // Small size for testing
  config.jpeg_quality = 12;
  config.fb_count = 1;
  config.grab_mode = CAMERA_GRAB_LATEST;

  // Try to init camera
  Serial.println("Initializing camera...");
  esp_err_t err = esp_camera_init(&config);

  if (err != ESP_OK) {
    Serial.printf("FAILED: Error 0x%x\n", err);
    Serial.println("\nTroubleshooting:");
    Serial.println("1. Check camera ribbon cable");
    Serial.println("2. Ensure power supply is 5V with enough current");
    Serial.println("3. Enable PSRAM in Tools menu");
    while (true) delay(1000);
  }

  Serial.println("SUCCESS: Camera OK!");
  Serial.println("\nNow try capturing a frame...");

  // Try to capture one frame
  camera_fb_t* fb = esp_camera_fb_get();
  if (!fb) {
    Serial.println("FAILED: Could not capture frame");
  } else {
    Serial.printf("SUCCESS: Captured %u bytes\n", fb->len);
    esp_camera_fb_return(fb);
  }

  Serial.println("\n=== Test Complete ===");
}

void loop() {
  delay(1000);
}
